daniel309/BBQBuddy/Media/graph_landscape.png

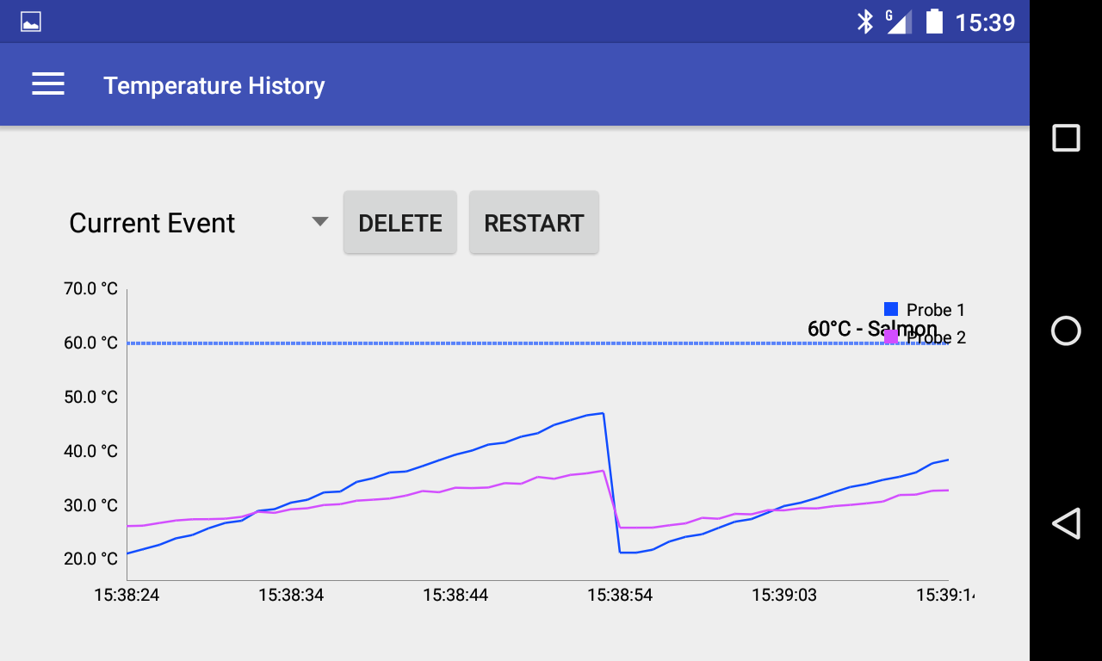
Media/graph_landscape.png
