daniel309/BBQBuddy/(commit log)

2016-05-15 added Arduino files
2016-05-15 add Arduino files
2016-05-15 share Arduino libraries and media
2016-08-17 replaced "start-over" with "merge" button
    [GraphFragment.java]
2016-08-17 changed internal temperature for "filet, medium"
2016-08-18 renamed merge button, set enabled when event != "current"
